theatomb/Elpis-Light-MPW3/readme_data/core_layout.png

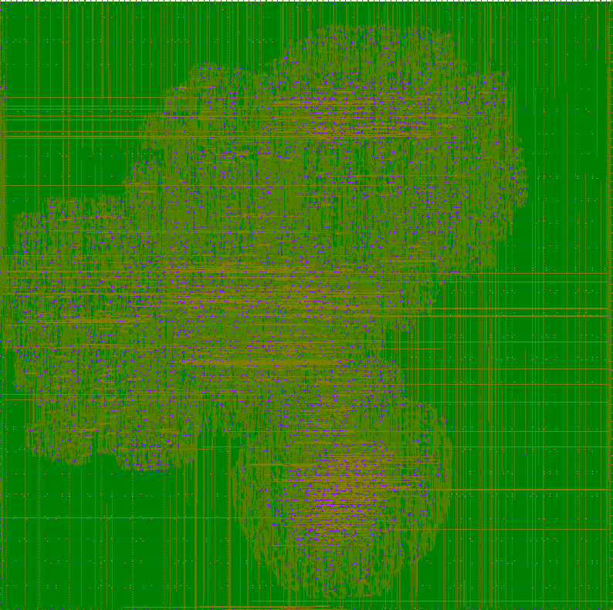
readme_data/core_layout.png
