theatomb/Elpis-Light-MPW3/readme_data/top-chip-layout2.png

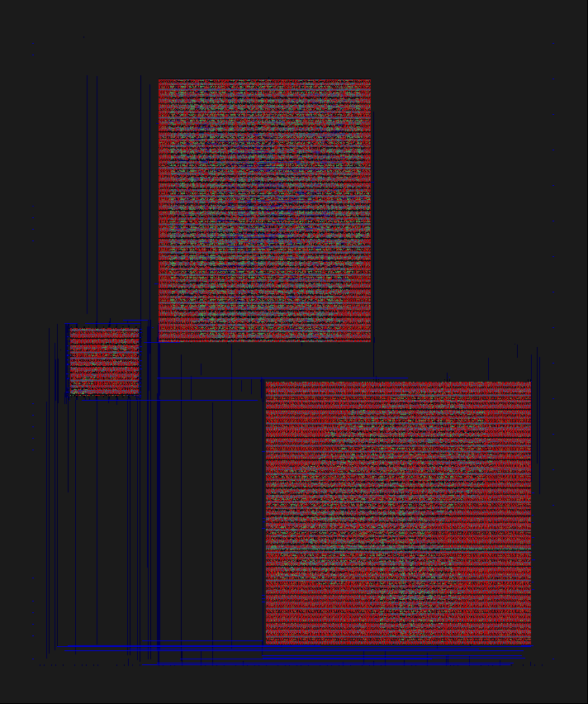
readme_data/top-chip-layout2.png
