theatomb/Elpis-Light-MPW3/signoff/chip_controller/final_summary_report.csv

 | design | design_name | config | flow_status | total_runtime | routed_runtime | (Cell/mm^2)/Core_Util | DIEAREA_mm^2 | CellPer_mm^2 | OpenDP_Util | Peak_Memory_Usage_MB | cell_count | tritonRoute_violations | Short_violations | MetSpc_violations | OffGrid_violations | MinHole_violations | Other_violations | Magic_violations | antenna_violations | lvs_total_errors | cvc_total_errors | klayout_violations | wire_length | vias | wns | pl_wns | optimized_wns | fastroute_wns | spef_wns | tns | pl_tns | optimized_tns | fastroute_tns | spef_tns | HPWL | routing_layer1_pct | routing_layer2_pct | routing_layer3_pct | routing_layer4_pct | routing_layer5_pct | routing_layer6_pct | wires_count | wire_bits | public_wires_count | public_wire_bits | memories_count | memory_bits | processes_count | cells_pre_abc | AND | DFF | NAND | NOR | OR | XOR | XNOR | MUX | inputs
0 | /project/openlane/chip_controller | chip_controller | chip_controller | flow_completed | 0h3m50s | -1 | 16450.0 | 0.16 | 8225.0 | 7.93 | 810.01 | 1316 | 0 | 0 | 0 | 0 | 0 | 0 | 0 | 12 | 0 | 0 | -1 | 182015 | 16026 | 0.0 | 0.0 | -1 | 0.0 | -1 | 0.0 | 0.0 | -1 | 0.0 | -1 | 149066767.0 | 12.58 | 31.4 | 23.78 | 1.46 | 0.16 | -1 | 1040 | 2611 | 75 | 1643 | 0 | 0 | 0 | 1226 | 0 | 0 | 0 | 0 | 0 | 0 | 0 | 4 | 327
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
