theatomb/Elpis-Light-MPW3/signoff/core/final_summary_report.csv

 | design | design_name | config | flow_status | total_runtime | routed_runtime | (Cell/mm^2)/Core_Util | DIEAREA_mm^2 | CellPer_mm^2 | OpenDP_Util | Peak_Memory_Usage_MB | cell_count | tritonRoute_violations | Short_violations | MetSpc_violations | OffGrid_violations | MinHole_violations | Other_violations | Magic_violations | antenna_violations | lvs_total_errors | cvc_total_errors | klayout_violations | wire_length | vias | wns | pl_wns | optimized_wns | fastroute_wns | spef_wns | tns | pl_tns | optimized_tns | fastroute_tns | spef_tns | HPWL | routing_layer1_pct | routing_layer2_pct | routing_layer3_pct | routing_layer4_pct | routing_layer5_pct | routing_layer6_pct | wires_count | wire_bits | public_wires_count | public_wire_bits | memories_count | memory_bits | processes_count | cells_pre_abc | AND | DFF | NAND | NOR | OR | XOR | XNOR | MUX | inputs
0 | /project/openlane/core | core | core | flow_completed | 0h41m13s | -1 | 24388.44444444445 | 2.25 | 12194.222222222224 | 12.65 | 1849.85 | 27437 | 0 | 0 | 0 | 0 | 0 | 0 | 0 | 48 | 0 | 0 | -1 | 1962978 | 276095 | 0.0 | 0.0 | -1 | 0.0 | -1 | 0.0 | 0.0 | -1 | 0.0 | -1 | 1504120811.0 | 0.48 | 21.74 | 19.97 | 1.97 | 0.63 | -1 | 20898 | 30810 | 571 | 10475 | 0 | 0 | 0 | 24133 | 0 | 0 | 0 | 0 | 0 | 0 | 0 | 4 | 4825
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
