theatomb/Elpis-Light-MPW3/spi/lvs/user_project_wrapper.spice

* NGSPICE file created from user_project_wrapper.ext - technology: sky130A

* Black-box entry subcircuit for chip_controller abstract view
.subckt chip_controller addr0_to_sram[0] addr0_to_sram[10] addr0_to_sram[11] addr0_to_sram[12]
+ addr0_to_sram[13] addr0_to_sram[14] addr0_to_sram[15] addr0_to_sram[16] addr0_to_sram[17]
+ addr0_to_sram[18] addr0_to_sram[19] addr0_to_sram[1] addr0_to_sram[2] addr0_to_sram[3]
+ addr0_to_sram[4] addr0_to_sram[5] addr0_to_sram[6] addr0_to_sram[7] addr0_to_sram[8]
+ addr0_to_sram[9] addr_in[0] addr_in[10] addr_in[11] addr_in[12] addr_in[13] addr_in[14]
+ addr_in[15] addr_in[16] addr_in[17] addr_in[18] addr_in[19] addr_in[1] addr_in[2]
+ addr_in[3] addr_in[4] addr_in[5] addr_in[6] addr_in[7] addr_in[8] addr_in[9] addr_to_core_mem[0]
+ addr_to_core_mem[10] addr_to_core_mem[11] addr_to_core_mem[12] addr_to_core_mem[13]
+ addr_to_core_mem[14] addr_to_core_mem[15] addr_to_core_mem[16] addr_to_core_mem[17]
+ addr_to_core_mem[18] addr_to_core_mem[19] addr_to_core_mem[1] addr_to_core_mem[2]
+ addr_to_core_mem[3] addr_to_core_mem[4] addr_to_core_mem[5] addr_to_core_mem[6]
+ addr_to_core_mem[7] addr_to_core_mem[8] addr_to_core_mem[9] clk core0_data_print[0]
+ core0_data_print[10] core0_data_print[11] core0_data_print[12] core0_data_print[13]
+ core0_data_print[14] core0_data_print[15] core0_data_print[16] core0_data_print[17]
+ core0_data_print[18] core0_data_print[19] core0_data_print[1] core0_data_print[20]
+ core0_data_print[21] core0_data_print[22] core0_data_print[23] core0_data_print[24]
+ core0_data_print[25] core0_data_print[26] core0_data_print[27] core0_data_print[28]
+ core0_data_print[29] core0_data_print[2] core0_data_print[30] core0_data_print[31]
+ core0_data_print[3] core0_data_print[4] core0_data_print[5] core0_data_print[6]
+ core0_data_print[7] core0_data_print[8] core0_data_print[9] csb0_to_sram data_out_to_core[0]
+ data_out_to_core[10] data_out_to_core[11] data_out_to_core[12] data_out_to_core[13]
+ data_out_to_core[14] data_out_to_core[15] data_out_to_core[16] data_out_to_core[17]
+ data_out_to_core[18] data_out_to_core[19] data_out_to_core[1] data_out_to_core[20]
+ data_out_to_core[21] data_out_to_core[22] data_out_to_core[23] data_out_to_core[24]
+ data_out_to_core[25] data_out_to_core[26] data_out_to_core[27] data_out_to_core[28]
+ data_out_to_core[29] data_out_to_core[2] data_out_to_core[30] data_out_to_core[31]
+ data_out_to_core[3] data_out_to_core[4] data_out_to_core[5] data_out_to_core[6]
+ data_out_to_core[7] data_out_to_core[8] data_out_to_core[9] data_to_core_mem[0]
+ data_to_core_mem[10] data_to_core_mem[11] data_to_core_mem[12] data_to_core_mem[13]
+ data_to_core_mem[14] data_to_core_mem[15] data_to_core_mem[16] data_to_core_mem[17]
+ data_to_core_mem[18] data_to_core_mem[19] data_to_core_mem[1] data_to_core_mem[20]
+ data_to_core_mem[21] data_to_core_mem[22] data_to_core_mem[23] data_to_core_mem[24]
+ data_to_core_mem[25] data_to_core_mem[26] data_to_core_mem[27] data_to_core_mem[28]
+ data_to_core_mem[29] data_to_core_mem[2] data_to_core_mem[30] data_to_core_mem[31]
+ data_to_core_mem[3] data_to_core_mem[4] data_to_core_mem[5] data_to_core_mem[6]
+ data_to_core_mem[7] data_to_core_mem[8] data_to_core_mem[9] din0_to_sram[0] din0_to_sram[10]
+ din0_to_sram[11] din0_to_sram[12] din0_to_sram[13] din0_to_sram[14] din0_to_sram[15]
+ din0_to_sram[16] din0_to_sram[17] din0_to_sram[18] din0_to_sram[19] din0_to_sram[1]
+ din0_to_sram[20] din0_to_sram[21] din0_to_sram[22] din0_to_sram[23] din0_to_sram[24]
+ din0_to_sram[25] din0_to_sram[26] din0_to_sram[27] din0_to_sram[28] din0_to_sram[29]
+ din0_to_sram[2] din0_to_sram[30] din0_to_sram[31] din0_to_sram[3] din0_to_sram[4]
+ din0_to_sram[5] din0_to_sram[6] din0_to_sram[7] din0_to_sram[8] din0_to_sram[9]
+ dout0_to_sram[0] dout0_to_sram[10] dout0_to_sram[11] dout0_to_sram[12] dout0_to_sram[13]
+ dout0_to_sram[14] dout0_to_sram[15] dout0_to_sram[16] dout0_to_sram[17] dout0_to_sram[18]
+ dout0_to_sram[19] dout0_to_sram[1] dout0_to_sram[20] dout0_to_sram[21] dout0_to_sram[22]
+ dout0_to_sram[23] dout0_to_sram[24] dout0_to_sram[25] dout0_to_sram[26] dout0_to_sram[27]
+ dout0_to_sram[28] dout0_to_sram[29] dout0_to_sram[2] dout0_to_sram[30] dout0_to_sram[31]
+ dout0_to_sram[3] dout0_to_sram[4] dout0_to_sram[5] dout0_to_sram[6] dout0_to_sram[7]
+ dout0_to_sram[8] dout0_to_sram[9] is_loading_memory_into_core is_ready_dataout_core0
+ is_ready_print_core0 la_data_in[0] la_data_in[100] la_data_in[101] la_data_in[102]
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
+ rd_data_out[64] rd_data_out[65] rd_data_out[66] rd_data_out[67] rd_data_out[68]
+ rd_data_out[69] rd_data_out[6] rd_data_out[70] rd_data_out[71] rd_data_out[72] rd_data_out[73]
+ rd_data_out[74] rd_data_out[75] rd_data_out[76] rd_data_out[77] rd_data_out[78]
+ rd_data_out[79] rd_data_out[7] rd_data_out[80] rd_data_out[81] rd_data_out[82] rd_data_out[83]
+ rd_data_out[84] rd_data_out[85] rd_data_out[86] rd_data_out[87] rd_data_out[88]
+ rd_data_out[89] rd_data_out[8] rd_data_out[90] rd_data_out[91] rd_data_out[92] rd_data_out[93]
+ rd_data_out[94] rd_data_out[95] rd_data_out[96] rd_data_out[97] rd_data_out[98]
+ rd_data_out[99] rd_data_out[9] read_enable_to_Elpis read_interactive_req_core0 read_value_to_Elpis[0]
+ read_value_to_Elpis[10] read_value_to_Elpis[11] read_value_to_Elpis[12] read_value_to_Elpis[13]
+ read_value_to_Elpis[14] read_value_to_Elpis[15] read_value_to_Elpis[16] read_value_to_Elpis[17]
+ read_value_to_Elpis[18] read_value_to_Elpis[19] read_value_to_Elpis[1] read_value_to_Elpis[20]
+ read_value_to_Elpis[21] read_value_to_Elpis[22] read_value_to_Elpis[23] read_value_to_Elpis[24]
+ read_value_to_Elpis[25] read_value_to_Elpis[26] read_value_to_Elpis[27] read_value_to_Elpis[28]
+ read_value_to_Elpis[29] read_value_to_Elpis[2] read_value_to_Elpis[30] read_value_to_Elpis[31]
+ read_value_to_Elpis[3] read_value_to_Elpis[4] read_value_to_Elpis[5] read_value_to_Elpis[6]
+ read_value_to_Elpis[7] read_value_to_Elpis[8] read_value_to_Elpis[9] ready req_out_core0
+ requested reset_core reset_mem_req rst spare_wen0_to_sram vccd1 vssd1 wb_clk_i wb_rst_i
+ wbs_dat_o[0] wbs_dat_o[10] wbs_dat_o[11] wbs_dat_o[12] wbs_dat_o[13] wbs_dat_o[14]
+ wbs_dat_o[15] wbs_dat_o[16] wbs_dat_o[17] wbs_dat_o[18] wbs_dat_o[19] wbs_dat_o[1]
+ wbs_dat_o[20] wbs_dat_o[21] wbs_dat_o[22] wbs_dat_o[23] wbs_dat_o[24] wbs_dat_o[25]
+ wbs_dat_o[26] wbs_dat_o[27] wbs_dat_o[28] wbs_dat_o[29] wbs_dat_o[2] wbs_dat_o[30]
+ wbs_dat_o[31] wbs_dat_o[3] wbs_dat_o[4] wbs_dat_o[5] wbs_dat_o[6] wbs_dat_o[7] wbs_dat_o[8]
+ wbs_dat_o[9] we we_to_sram wr_data[0] wr_data[100] wr_data[101] wr_data[102] wr_data[103]
+ wr_data[104] wr_data[105] wr_data[106] wr_data[107] wr_data[108] wr_data[109] wr_data[10]
+ wr_data[110] wr_data[111] wr_data[112] wr_data[113] wr_data[114] wr_data[115] wr_data[116]
+ wr_data[117] wr_data[118] wr_data[119] wr_data[11] wr_data[120] wr_data[121] wr_data[122]
+ wr_data[123] wr_data[124] wr_data[125] wr_data[126] wr_data[127] wr_data[12] wr_data[13]
+ wr_data[14] wr_data[15] wr_data[16] wr_data[17] wr_data[18] wr_data[19] wr_data[1]
+ wr_data[20] wr_data[21] wr_data[22] wr_data[23] wr_data[24] wr_data[25] wr_data[26]
+ wr_data[27] wr_data[28] wr_data[29] wr_data[2] wr_data[30] wr_data[31] wr_data[32]
+ wr_data[33] wr_data[34] wr_data[35] wr_data[36] wr_data[37] wr_data[38] wr_data[39]
+ wr_data[3] wr_data[40] wr_data[41] wr_data[42] wr_data[43] wr_data[44] wr_data[45]
+ wr_data[46] wr_data[47] wr_data[48] wr_data[49] wr_data[4] wr_data[50] wr_data[51]
+ wr_data[52] wr_data[53] wr_data[54] wr_data[55] wr_data[56] wr_data[57] wr_data[58]
+ wr_data[59] wr_data[5] wr_data[60] wr_data[61] wr_data[62] wr_data[63] wr_data[64]
+ wr_data[65] wr_data[66] wr_data[67] wr_data[68] wr_data[69] wr_data[6] wr_data[70]
+ wr_data[71] wr_data[72] wr_data[73] wr_data[74] wr_data[75] wr_data[76] wr_data[77]
+ wr_data[78] wr_data[79] wr_data[7] wr_data[80] wr_data[81] wr_data[82] wr_data[83]
+ wr_data[84] wr_data[85] wr_data[86] wr_data[87] wr_data[88] wr_data[89] wr_data[8]
+ wr_data[90] wr_data[91] wr_data[92] wr_data[93] wr_data[94] wr_data[95] wr_data[96]
+ wr_data[97] wr_data[98] wr_data[99] wr_data[9]
.ends

* Black-box entry subcircuit for core abstract view
.subckt core clk data_from_mem[0] data_from_mem[100] data_from_mem[101] data_from_mem[102]
+ data_from_mem[103] data_from_mem[104] data_from_mem[105] data_from_mem[106] data_from_mem[107]
+ data_from_mem[108] data_from_mem[109] data_from_mem[10] data_from_mem[110] data_from_mem[111]
+ data_from_mem[112] data_from_mem[113] data_from_mem[114] data_from_mem[115] data_from_mem[116]
+ data_from_mem[117] data_from_mem[118] data_from_mem[119] data_from_mem[11] data_from_mem[120]
+ data_from_mem[121] data_from_mem[122] data_from_mem[123] data_from_mem[124] data_from_mem[125]
+ data_from_mem[126] data_from_mem[127] data_from_mem[12] data_from_mem[13] data_from_mem[14]
+ data_from_mem[15] data_from_mem[16] data_from_mem[17] data_from_mem[18] data_from_mem[19]
+ data_from_mem[1] data_from_mem[20] data_from_mem[21] data_from_mem[22] data_from_mem[23]
+ data_from_mem[24] data_from_mem[25] data_from_mem[26] data_from_mem[27] data_from_mem[28]
+ data_from_mem[29] data_from_mem[2] data_from_mem[30] data_from_mem[31] data_from_mem[32]
+ data_from_mem[33] data_from_mem[34] data_from_mem[35] data_from_mem[36] data_from_mem[37]
+ data_from_mem[38] data_from_mem[39] data_from_mem[3] data_from_mem[40] data_from_mem[41]
+ data_from_mem[42] data_from_mem[43] data_from_mem[44] data_from_mem[45] data_from_mem[46]
+ data_from_mem[47] data_from_mem[48] data_from_mem[49] data_from_mem[4] data_from_mem[50]
+ data_from_mem[51] data_from_mem[52] data_from_mem[53] data_from_mem[54] data_from_mem[55]
+ data_from_mem[56] data_from_mem[57] data_from_mem[58] data_from_mem[59] data_from_mem[5]
+ data_from_mem[60] data_from_mem[61] data_from_mem[62] data_from_mem[63] data_from_mem[64]
+ data_from_mem[65] data_from_mem[66] data_from_mem[67] data_from_mem[68] data_from_mem[69]
+ data_from_mem[6] data_from_mem[70] data_from_mem[71] data_from_mem[72] data_from_mem[73]
+ data_from_mem[74] data_from_mem[75] data_from_mem[76] data_from_mem[77] data_from_mem[78]
+ data_from_mem[79] data_from_mem[7] data_from_mem[80] data_from_mem[81] data_from_mem[82]
+ data_from_mem[83] data_from_mem[84] data_from_mem[85] data_from_mem[86] data_from_mem[87]
+ data_from_mem[88] data_from_mem[89] data_from_mem[8] data_from_mem[90] data_from_mem[91]
+ data_from_mem[92] data_from_mem[93] data_from_mem[94] data_from_mem[95] data_from_mem[96]
+ data_from_mem[97] data_from_mem[98] data_from_mem[99] data_from_mem[9] hex_out[0]
+ hex_out[10] hex_out[11] hex_out[12] hex_out[13] hex_out[14] hex_out[15] hex_out[16]
+ hex_out[17] hex_out[18] hex_out[19] hex_out[1] hex_out[20] hex_out[21] hex_out[22]
+ hex_out[23] hex_out[24] hex_out[25] hex_out[26] hex_out[27] hex_out[28] hex_out[29]
+ hex_out[2] hex_out[30] hex_out[31] hex_out[3] hex_out[4] hex_out[5] hex_out[6] hex_out[7]
+ hex_out[8] hex_out[9] hex_req is_mem_ready is_mem_req is_mem_req_reset is_memory_we
+ is_print_done mem_addr_out[0] mem_addr_out[10] mem_addr_out[11] mem_addr_out[12]
+ mem_addr_out[13] mem_addr_out[14] mem_addr_out[15] mem_addr_out[16] mem_addr_out[17]
+ mem_addr_out[18] mem_addr_out[19] mem_addr_out[1] mem_addr_out[2] mem_addr_out[3]
+ mem_addr_out[4] mem_addr_out[5] mem_addr_out[6] mem_addr_out[7] mem_addr_out[8]
+ mem_addr_out[9] mem_data_out[0] mem_data_out[100] mem_data_out[101] mem_data_out[102]
+ mem_data_out[103] mem_data_out[104] mem_data_out[105] mem_data_out[106] mem_data_out[107]
+ mem_data_out[108] mem_data_out[109] mem_data_out[10] mem_data_out[110] mem_data_out[111]
+ mem_data_out[112] mem_data_out[113] mem_data_out[114] mem_data_out[115] mem_data_out[116]
+ mem_data_out[117] mem_data_out[118] mem_data_out[119] mem_data_out[11] mem_data_out[120]
+ mem_data_out[121] mem_data_out[122] mem_data_out[123] mem_data_out[124] mem_data_out[125]
+ mem_data_out[126] mem_data_out[127] mem_data_out[12] mem_data_out[13] mem_data_out[14]
+ mem_data_out[15] mem_data_out[16] mem_data_out[17] mem_data_out[18] mem_data_out[19]
+ mem_data_out[1] mem_data_out[20] mem_data_out[21] mem_data_out[22] mem_data_out[23]
+ mem_data_out[24] mem_data_out[25] mem_data_out[26] mem_data_out[27] mem_data_out[28]
+ mem_data_out[29] mem_data_out[2] mem_data_out[30] mem_data_out[31] mem_data_out[32]
+ mem_data_out[33] mem_data_out[34] mem_data_out[35] mem_data_out[36] mem_data_out[37]
+ mem_data_out[38] mem_data_out[39] mem_data_out[3] mem_data_out[40] mem_data_out[41]
+ mem_data_out[42] mem_data_out[43] mem_data_out[44] mem_data_out[45] mem_data_out[46]
+ mem_data_out[47] mem_data_out[48] mem_data_out[49] mem_data_out[4] mem_data_out[50]
+ mem_data_out[51] mem_data_out[52] mem_data_out[53] mem_data_out[54] mem_data_out[55]
+ mem_data_out[56] mem_data_out[57] mem_data_out[58] mem_data_out[59] mem_data_out[5]
+ mem_data_out[60] mem_data_out[61] mem_data_out[62] mem_data_out[63] mem_data_out[64]
+ mem_data_out[65] mem_data_out[66] mem_data_out[67] mem_data_out[68] mem_data_out[69]
+ mem_data_out[6] mem_data_out[70] mem_data_out[71] mem_data_out[72] mem_data_out[73]
+ mem_data_out[74] mem_data_out[75] mem_data_out[76] mem_data_out[77] mem_data_out[78]
+ mem_data_out[79] mem_data_out[7] mem_data_out[80] mem_data_out[81] mem_data_out[82]
+ mem_data_out[83] mem_data_out[84] mem_data_out[85] mem_data_out[86] mem_data_out[87]
+ mem_data_out[88] mem_data_out[89] mem_data_out[8] mem_data_out[90] mem_data_out[91]
+ mem_data_out[92] mem_data_out[93] mem_data_out[94] mem_data_out[95] mem_data_out[96]
+ mem_data_out[97] mem_data_out[98] mem_data_out[99] mem_data_out[9] read_interactive_ready
+ read_interactive_req read_interactive_value[0] read_interactive_value[10] read_interactive_value[11]
+ read_interactive_value[12] read_interactive_value[13] read_interactive_value[14]
+ read_interactive_value[15] read_interactive_value[16] read_interactive_value[17]
+ read_interactive_value[18] read_interactive_value[19] read_interactive_value[1]
+ read_interactive_value[20] read_interactive_value[21] read_interactive_value[22]
+ read_interactive_value[23] read_interactive_value[24] read_interactive_value[25]
+ read_interactive_value[26] read_interactive_value[27] read_interactive_value[28]
+ read_interactive_value[29] read_interactive_value[2] read_interactive_value[30]
+ read_interactive_value[31] read_interactive_value[3] read_interactive_value[4] read_interactive_value[5]
+ read_interactive_value[6] read_interactive_value[7] read_interactive_value[8] read_interactive_value[9]
+ rst vccd1 vssd1
.ends

* Black-box entry subcircuit for custom_sram abstract view
.subckt custom_sram a[0] a[10] a[11] a[12] a[13] a[14] a[15] a[16] a[17] a[18] a[19]
+ a[1] a[2] a[3] a[4] a[5] a[6] a[7] a[8] a[9] clk csb0_to_sram d[0] d[10] d[11] d[12]
+ d[13] d[14] d[15] d[16] d[17] d[18] d[19] d[1] d[20] d[21] d[22] d[23] d[24] d[25]
+ d[26] d[27] d[28] d[29] d[2] d[30] d[31] d[3] d[4] d[5] d[6] d[7] d[8] d[9] q[0]
+ q[10] q[11] q[12] q[13] q[14] q[15] q[16] q[17] q[18] q[19] q[1] q[20] q[21] q[22]
+ q[23] q[24] q[25] q[26] q[27] q[28] q[29] q[2] q[30] q[31] q[3] q[4] q[5] q[6] q[7]
+ q[8] q[9] spare_wen0_to_sram vccd1 vssd1 we
.ends
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
