theatomb/Elpis-Light-MPW3/verilog/gl/user_project_wrapper.v

module user_project_wrapper (user_clock2,
    vccd1,
    vccd2,
    vdda1,
    vdda2,
    vssa1,
    vssa2,
    vssd1,
    vssd2,
    wb_clk_i,
    wb_rst_i,
    wbs_ack_o,
    wbs_cyc_i,
    wbs_stb_i,
    wbs_we_i,
    analog_io,
    io_in,
    io_oeb,
    io_out,
    la_data_in,
    la_data_out,
    la_oenb,
    user_irq,
    wbs_adr_i,
    wbs_dat_i,
    wbs_dat_o,
    wbs_sel_i);
 input user_clock2;
 input vccd1;
 input vccd2;
 input vdda1;
 input vdda2;
 input vssa1;
 input vssa2;
 input vssd1;
 input vssd2;
 input wb_clk_i;
 input wb_rst_i;
 output wbs_ack_o;
 input wbs_cyc_i;
 input wbs_stb_i;
 input wbs_we_i;
 inout [28:0] analog_io;
 input [37:0] io_in;
 output [37:0] io_oeb;
 output [37:0] io_out;
 input [127:0] la_data_in;
 output [127:0] la_data_out;
 input [127:0] la_oenb;
 output [2:0] user_irq;
 input [31:0] wbs_adr_i;
 input [31:0] wbs_dat_i;
 output [31:0] wbs_dat_o;
 input [3:0] wbs_sel_i;

 wire \addr0_to_sram[0] ;
 wire \addr0_to_sram[10] ;
 wire \addr0_to_sram[11] ;
 wire \addr0_to_sram[12] ;
 wire \addr0_to_sram[13] ;
 wire \addr0_to_sram[14] ;
 wire \addr0_to_sram[15] ;
 wire \addr0_to_sram[16] ;
 wire \addr0_to_sram[17] ;
 wire \addr0_to_sram[18] ;
 wire \addr0_to_sram[19] ;
 wire \addr0_to_sram[1] ;
 wire \addr0_to_sram[2] ;
 wire \addr0_to_sram[3] ;
 wire \addr0_to_sram[4] ;
 wire \addr0_to_sram[5] ;
 wire \addr0_to_sram[6] ;
 wire \addr0_to_sram[7] ;
 wire \addr0_to_sram[8] ;
 wire \addr0_to_sram[9] ;
 wire \addr_to_core_mem[0] ;
 wire \addr_to_core_mem[10] ;
 wire \addr_to_core_mem[11] ;
 wire \addr_to_core_mem[12] ;
 wire \addr_to_core_mem[13] ;
 wire \addr_to_core_mem[14] ;
 wire \addr_to_core_mem[15] ;
 wire \addr_to_core_mem[16] ;
 wire \addr_to_core_mem[17] ;
 wire \addr_to_core_mem[18] ;
 wire \addr_to_core_mem[19] ;
 wire \addr_to_core_mem[1] ;
 wire \addr_to_core_mem[2] ;
 wire \addr_to_core_mem[3] ;
 wire \addr_to_core_mem[4] ;
 wire \addr_to_core_mem[5] ;
 wire \addr_to_core_mem[6] ;
 wire \addr_to_core_mem[7] ;
 wire \addr_to_core_mem[8] ;
 wire \addr_to_core_mem[9] ;
 wire clk;
 wire \core0_data_print[0] ;
 wire \core0_data_print[10] ;
 wire \core0_data_print[11] ;
 wire \core0_data_print[12] ;
 wire \core0_data_print[13] ;
 wire \core0_data_print[14] ;
 wire \core0_data_print[15] ;
 wire \core0_data_print[16] ;
 wire \core0_data_print[17] ;
 wire \core0_data_print[18] ;
 wire \core0_data_print[19] ;
 wire \core0_data_print[1] ;
 wire \core0_data_print[20] ;
 wire \core0_data_print[21] ;
 wire \core0_data_print[22] ;
 wire \core0_data_print[23] ;
 wire \core0_data_print[24] ;
 wire \core0_data_print[25] ;
 wire \core0_data_print[26] ;
 wire \core0_data_print[27] ;
 wire \core0_data_print[28] ;
 wire \core0_data_print[29] ;
 wire \core0_data_print[2] ;
 wire \core0_data_print[30] ;
 wire \core0_data_print[31] ;
 wire \core0_data_print[3] ;
 wire \core0_data_print[4] ;
 wire \core0_data_print[5] ;
 wire \core0_data_print[6] ;
 wire \core0_data_print[7] ;
 wire \core0_data_print[8] ;
 wire \core0_data_print[9] ;
 wire core0_is_mem_we;
 wire core0_need_reset_mem_req;
 wire \core0_to_mem_address[0] ;
 wire \core0_to_mem_address[10] ;
 wire \core0_to_mem_address[11] ;
 wire \core0_to_mem_address[12] ;
 wire \core0_to_mem_address[13] ;
 wire \core0_to_mem_address[14] ;
 wire \core0_to_mem_address[15] ;
 wire \core0_to_mem_address[16] ;
 wire \core0_to_mem_address[17] ;
 wire \core0_to_mem_address[18] ;
 wire \core0_to_mem_address[19] ;
 wire \core0_to_mem_address[1] ;
 wire \core0_to_mem_address[2] ;
 wire \core0_to_mem_address[3] ;
 wire \core0_to_mem_address[4] ;
 wire \core0_to_mem_address[5] ;
 wire \core0_to_mem_address[6] ;
 wire \core0_to_mem_address[7] ;
 wire \core0_to_mem_address[8] ;
 wire \core0_to_mem_address[9] ;
 wire \core0_to_mem_data[0] ;
 wire \core0_to_mem_data[100] ;
 wire \core0_to_mem_data[101] ;
 wire \core0_to_mem_data[102] ;
 wire \core0_to_mem_data[103] ;
 wire \core0_to_mem_data[104] ;
 wire \core0_to_mem_data[105] ;
 wire \core0_to_mem_data[106] ;
 wire \core0_to_mem_data[107] ;
 wire \core0_to_mem_data[108] ;
 wire \core0_to_mem_data[109] ;
 wire \core0_to_mem_data[10] ;
 wire \core0_to_mem_data[110] ;
 wire \core0_to_mem_data[111] ;
 wire \core0_to_mem_data[112] ;
 wire \core0_to_mem_data[113] ;
 wire \core0_to_mem_data[114] ;
 wire \core0_to_mem_data[115] ;
 wire \core0_to_mem_data[116] ;
 wire \core0_to_mem_data[117] ;
 wire \core0_to_mem_data[118] ;
 wire \core0_to_mem_data[119] ;
 wire \core0_to_mem_data[11] ;
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
 wire \read_value_to_Elpis[4] ;
 wire \read_value_to_Elpis[5] ;
 wire \read_value_to_Elpis[6] ;
 wire \read_value_to_Elpis[7] ;
 wire \read_value_to_Elpis[8] ;
 wire \read_value_to_Elpis[9] ;
 wire req_out_core0;
 wire reset_core;
 wire rst;
 wire spare_wen0_to_sram;
 wire we_to_sram;

 chip_controller chip_controller (.clk(clk),
    .csb0_to_sram(csb0_to_sram),
    .is_loading_memory_into_core(is_loading_memory_into_core),
    .is_ready_dataout_core0(is_ready_dataout_core0),
    .is_ready_print_core0(is_ready_print_core0),
    .read_enable_to_Elpis(read_enable_to_Elpis),
    .read_interactive_req_core0(read_interactive_req_core0),
    .ready(is_mem_ready),
    .req_out_core0(req_out_core0),
    .requested(is_mem_req),
    .reset_core(reset_core),
    .reset_mem_req(core0_need_reset_mem_req),
    .rst(rst),
    .spare_wen0_to_sram(spare_wen0_to_sram),
    .vccd1(vccd1),
    .vssd1(vssd1),
    .wb_clk_i(wb_clk_i),
    .wb_rst_i(wb_rst_i),
    .we(core0_is_mem_we),
    .we_to_sram(we_to_sram),
    .addr0_to_sram({\addr0_to_sram[19] ,
    \addr0_to_sram[18] ,
    \addr0_to_sram[17] ,
    \addr0_to_sram[16] ,
    \addr0_to_sram[15] ,
    \addr0_to_sram[14] ,
    \addr0_to_sram[13] ,
    \addr0_to_sram[12] ,
    \addr0_to_sram[11] ,
    \addr0_to_sram[10] ,
    \addr0_to_sram[9] ,
    \addr0_to_sram[8] ,
    \addr0_to_sram[7] ,
    \addr0_to_sram[6] ,
    \addr0_to_sram[5] ,
    \addr0_to_sram[4] ,
    \addr0_to_sram[3] ,
    \addr0_to_sram[2] ,
    \addr0_to_sram[1] ,
    \addr0_to_sram[0] }),
    .addr_in({\core0_to_mem_address[19] ,
    \core0_to_mem_address[18] ,
    \core0_to_mem_address[17] ,
    \core0_to_mem_address[16] ,
    \core0_to_mem_address[15] ,
    \core0_to_mem_address[14] ,
    \core0_to_mem_address[13] ,
    \core0_to_mem_address[12] ,
    \core0_to_mem_address[11] ,
    \core0_to_mem_address[10] ,
    \core0_to_mem_address[9] ,
    \core0_to_mem_address[8] ,
    \core0_to_mem_address[7] ,
    \core0_to_mem_address[6] ,
    \core0_to_mem_address[5] ,
    \core0_to_mem_address[4] ,
    \core0_to_mem_address[3] ,
    \core0_to_mem_address[2] ,
    \core0_to_mem_address[1] ,
    \core0_to_mem_address[0] }),
    .addr_to_core_mem({\addr_to_core_mem[19] ,
    \addr_to_core_mem[18] ,
    \addr_to_core_mem[17] ,
    \addr_to_core_mem[16] ,
    \addr_to_core_mem[15] ,
    \addr_to_core_mem[14] ,
    \addr_to_core_mem[13] ,
    \addr_to_core_mem[12] ,
    \addr_to_core_mem[11] ,
    \addr_to_core_mem[10] ,
    \addr_to_core_mem[9] ,
    \addr_to_core_mem[8] ,
    \addr_to_core_mem[7] ,
    \addr_to_core_mem[6] ,
    \addr_to_core_mem[5] ,
    \addr_to_core_mem[4] ,
    \addr_to_core_mem[3] ,
    \addr_to_core_mem[2] ,
    \addr_to_core_mem[1] ,
    \addr_to_core_mem[0] }),
    .core0_data_print({\core0_data_print[31] ,
    \core0_data_print[30] ,
    \core0_data_print[29] ,
    \core0_data_print[28] ,
    \core0_data_print[27] ,
    \core0_data_print[26] ,
    \core0_data_print[25] ,
    \core0_data_print[24] ,
    \core0_data_print[23] ,
    \core0_data_print[22] ,
    \core0_data_print[21] ,
    \core0_data_print[20] ,
    \core0_data_print[19] ,
    \core0_data_print[18] ,
    \core0_data_print[17] ,
    \core0_data_print[16] ,
    \core0_data_print[15] ,
    \core0_data_print[14] ,
    \core0_data_print[13] ,
    \core0_data_print[12] ,
    \core0_data_print[11] ,
    \core0_data_print[10] ,
    \core0_data_print[9] ,
    \core0_data_print[8] ,
    \core0_data_print[7] ,
    \core0_data_print[6] ,
    \core0_data_print[5] ,
    \core0_data_print[4] ,
    \core0_data_print[3] ,
    \core0_data_print[2] ,
    \core0_data_print[1] ,
    \core0_data_print[0] }),
    .data_out_to_core({\data_out_to_core[31] ,
    \data_out_to_core[30] ,
    \data_out_to_core[29] ,
    \data_out_to_core[28] ,
    \data_out_to_core[27] ,
    \data_out_to_core[26] ,
    \data_out_to_core[25] ,
    \data_out_to_core[24] ,
    \data_out_to_core[23] ,
    \data_out_to_core[22] ,
    \data_out_to_core[21] ,
    \data_out_to_core[20] ,
    \data_out_to_core[19] ,
    \data_out_to_core[18] ,
    \data_out_to_core[17] ,
    \data_out_to_core[16] ,
    \data_out_to_core[15] ,
    \data_out_to_core[14] ,
    \data_out_to_core[13] ,
    \data_out_to_core[12] ,
    \data_out_to_core[11] ,
    \data_out_to_core[10] ,
    \data_out_to_core[9] ,
    \data_out_to_core[8] ,
    \data_out_to_core[7] ,
    \data_out_to_core[6] ,
    \data_out_to_core[5] ,
    \data_out_to_core[4] ,
    \data_out_to_core[3] ,
    \data_out_to_core[2] ,
    \data_out_to_core[1] ,
    \data_out_to_core[0] }),
    .data_to_core_mem({\data_to_core_mem[31] ,
    \data_to_core_mem[30] ,
    \data_to_core_mem[29] ,
    \data_to_core_mem[28] ,
    \data_to_core_mem[27] ,
    \data_to_core_mem[26] ,
    \data_to_core_mem[25] ,
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
    \dout0_to_sram[26] ,
    \dout0_to_sram[25] ,
    \dout0_to_sram[24] ,
    \dout0_to_sram[23] ,
    \dout0_to_sram[22] ,
    \dout0_to_sram[21] ,
    \dout0_to_sram[20] ,
    \dout0_to_sram[19] ,
    \dout0_to_sram[18] ,
    \dout0_to_sram[17] ,
    \dout0_to_sram[16] ,
    \dout0_to_sram[15] ,
    \dout0_to_sram[14] ,
    \dout0_to_sram[13] ,
    \dout0_to_sram[12] ,
    \dout0_to_sram[11] ,
    \dout0_to_sram[10] ,
    \dout0_to_sram[9] ,
    \dout0_to_sram[8] ,
    \dout0_to_sram[7] ,
    \dout0_to_sram[6] ,
    \dout0_to_sram[5] ,
    \dout0_to_sram[4] ,
    \dout0_to_sram[3] ,
    \dout0_to_sram[2] ,
    \dout0_to_sram[1] ,
    \dout0_to_sram[0] }));
endmodule
