theatomb/Elpis-Light-MPW3/verilog/rtl/uprj_netlists.v

// SPDX-FileCopyrightText: 2020 Efabless Corporation
//
// Licensed under the Apache License, Version 2.0 (the "License");
// you may not use this file except in compliance with the License.
// You may obtain a copy of the License at
//
//      http://www.apache.org/licenses/LICENSE-2.0
//
// Unless required by applicable law or agreed to in writing, software
// distributed under the License is distributed on an "AS IS" BASIS,
// WITHOUT WARRANTIES OR CONDITIONS OF ANY KIND, either express or implied.
// See the License for the specific language governing permissions and
// limitations under the License.
// SPDX-License-Identifier: Apache-2.0

// Include caravel global defines for the number of the user project IO pads 
`include "defines.v"
`define USE_POWER_PINS

`ifdef GL
    // Assume default net type to be wire because GL netlists don't have the wire definitions
    `default_nettype wire
    `include "gl/user_project_wrapper.v"
    `include "gl/chip_controller.v"
    `include "gl/custom_sram.v"
    `include "gl/core.v"
`else
    `include "user_project_wrapper.v"
    `include "elpis/alu.v"
    `include "elpis/arbiter.v"
    `include "elpis/betweenStages.v"
    `include "elpis/branchComparer.v"
    `include "elpis/cache.v"
    `include "elpis/chip_controller.v"
    `include "elpis/controlunit.v"
    `include "elpis/core.v"
    `include "elpis/custom_sram.v"
    `include "elpis/datapath.v"
    `include "elpis/decoder.v"
    `include "elpis/definitions.v"
    `include "elpis/forwardingunit.v"
    `include "elpis/hazardDetectionUnit.v"
    `include "elpis/IO_arbiter.v"
    `include "elpis/regfile.v"
    `include "elpis/specialreg.v"
    `include "elpis/sram_wrapper.v"
    `include "elpis/storebuffer.v"
    `include "elpis/utils.v"
`endif
