theatomb/Elpis-Light-MPW3/(commit log)

2021-10-29 Initial files
    [final_summary_report.csv, macro.cfg, pin_order.cfg]
2021-10-29 Added rtl and macros configuration
    [final_summary_report.csv, macro.cfg, pin_order.cfg]
2021-10-31 Workflow completed for regfile, specialregfile, storebuffer and MEM_WB
    [final_summary_report.csv]
2021-11-01 datapath, caches and core completing the workflow. They have a warning related to 25-spef_extraction_sta.slew.rpt
    [final_summary_report.csv, macro.cfg]
2021-11-02 Added and completed flow for custom_sram
    [final_summary_report.csv]
2021-11-02 Completed workflow for o_arbiter, i_arbiter, sram_wrapper, custom_sram
    [final_summary_report.csv]
2021-11-02 Added multiplication instruction, fixed sram_wrapper, added chip_controller logic, first steps to do dv tests
    [final_summary_report.csv, macro.cfg, pin_order.cfg]
2021-11-03 Added chip controller openlane workflow, core still has problems with timing
    [final_summary_report.csv]
2021-11-03 joining the macros and improved test
    [macro.cfg]
2021-11-04 1st test working!
    [final_summary_report.csv]
2021-11-05 Added and fixed testIn, read value at elpis from Elpis
    [testBasicOps.c, testIn.c, testIn_tb.v, testOut.c]
2021-11-05 Changed the size of the custom_ram at definition.v to have 512 words instead of 8192 and be able to complete the workflow
    [final_summary_report.csv]
2021-11-06 printing test not working yet
    [final_summary_report.csv]
2021-11-06 printing test compiles but still fails
    [testPrint.c, testPrint_tb.v]
2021-11-06 solved bug in chip controller - now printing test is passing!
    [chip_controller.v]
2021-11-06 Core fixed error timing issues with hold slack margins
    [final_summary_report.csv]
2021-11-08 Added vcd pins, user_project_wrapper doesn't complete the workflow
    [final_summary_report.csv, macro.cfg]
2021-11-08 Added vcd pins to core at user_project_wrapper
    [final_summary_report.csv]
2021-11-09 Added pin_order.cfg to core, custom_sram and chip_controller. Glue together chip_controller, sram_wrapper, i_arbiter and o_arbiter. Fixed LVS errors executing user_project_wrapper
    [final_summary_report.csv, macro.cfg, pin_order.cfg]
2021-11-09 Workflow completed with all the macros
    [final_summary_report.csv, macro.cfg]
2021-11-09 Deleting comments in user_project_wrapper.cfg, workflow.sh and macro.cfg
    [macro.cfg]
2021-11-10 getting repo ready
    [final_summary_report.csv, pin_order.cfg]
2021-11-12 Fixed slew violations in chip controller, trying to fix the DRC violation at tapeout precheck
    [final_summary_report.csv, macro.cfg]
2021-11-13 Another try to eliminate the DRC of tapeout precheck
    [final_summary_report.csv, macro.cfg]
2021-11-14 Tryied to fix some slew violations, updated photos
    [final_summary_report.csv]
2021-11-14 Trying to reduce slew violations in the wrapper
    [final_summary_report.csv]
2021-11-14 Trying to pass tapeout checkout with less slew violations
    [final_summary_report.csv]
