theatomb/Elpis-Light-MPW3/(notices)

Notices in the files:
README.md:
License: BSD 3-Clause
